Julien83910/Flipper/Rapport séance/Rapport séance 7.pdf

Séance du 16/02

Aujourd’hui je me suis occupé des bumpers qui fonctionnent comme des interrupteurs, donc la bille qui fait contacte entre le haut du bumper grâce à un fil de cuivre et le sol grâce à une plaque de cuivre aussi (malheureusement j’ai d’abord essayé avec une plaque en aluminium, le bumper fonctionnait mais on ne pouvait pas soudé dessus). Résultat le bumper fonctionnais, j’ai dû quand même redimensionner un peu mes pièces, il me reste plus qu’à les brancher correctement sur le plateau de jeu.

J’ai aussi construit la rampe de lancement, fais les trous dans la planche pour les bumpers.

Pour finir j’ai commencé à brancher les 2 gâchettes pour propulser la bille avec les boutons et les solénoïdes mais je n’ai pas eu le temps de finir le branchement.
