Julien83910/Flipper/Rapport séance/Rapport séance du 06.pdf

Rapport séance du 09/02

Aujourd’hui, j'ai collé toutes mes pièces sur le plateau de jeu, il est donc au complet. De plus, j’ai redimensionné les supports pour poser les capteurs et les moteurs solénoïdes, puis je les ai fait imprimer.

J’ai aussi essayé de faire fonctionner le moteur avec la gâchette à travers le plateau de jeu avec le mécanisme qui les relie, et ceci est un succès, les gâchettes sont ainsi fonctionnelles.

J’ai aussi soudé les fils sur les moteurs solénoïdes pour pouvoir les brancher.
