Julien83910/Flipper/Rapport séance/Rapport séance 05.pdf

Rapport séance 02/02/2023

Lors de cette séance, j'ai remplacé tous les capteurs électromagnétiques par des capteurs de lumières, car à travers le plexiglas, la lumière se détecte mieux. En effet, à travers les trous sur la planche, j'ai collé des disques de plexiglas que j’ai dessiné et découpé au préalable. Les capteurs ont été branchés, testés et approuvés.

De plus j’ai dessiné les cales qui vont servir à caler les capteurs et les moteurs solénoïde derrières la planche.

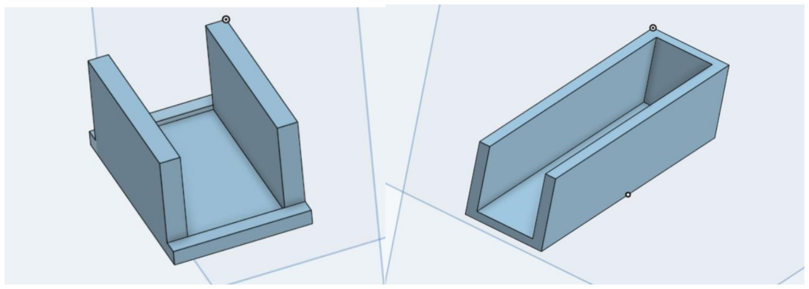
[picture p8: figure]
