Julien83910/Flipper/diapo projet.pdf

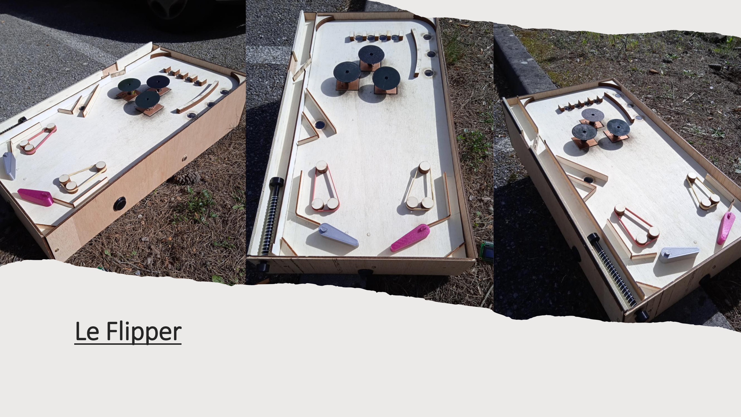
[picture p9: page 1]

FamilyID=Office_ArchiveTorn

Le Flipper

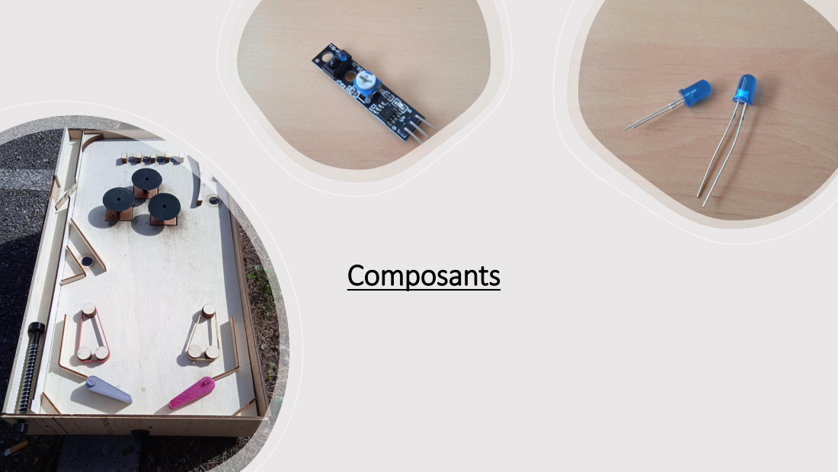
[picture p10: page 2]
Composants

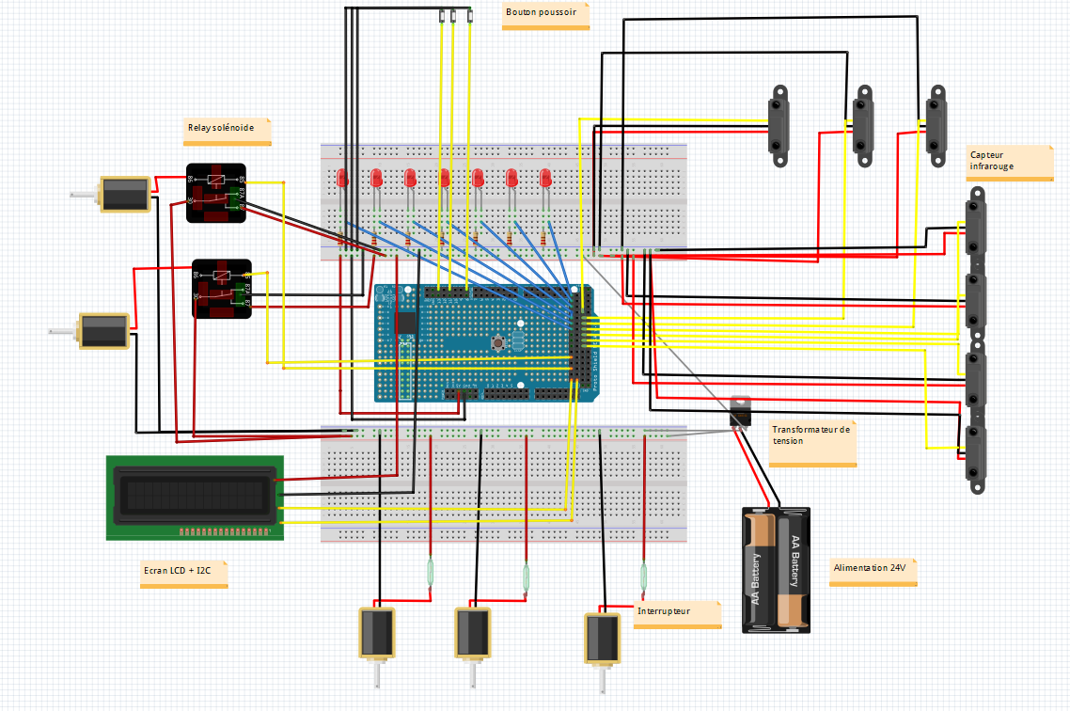
[picture p11: figure]

Schéma du
câblage

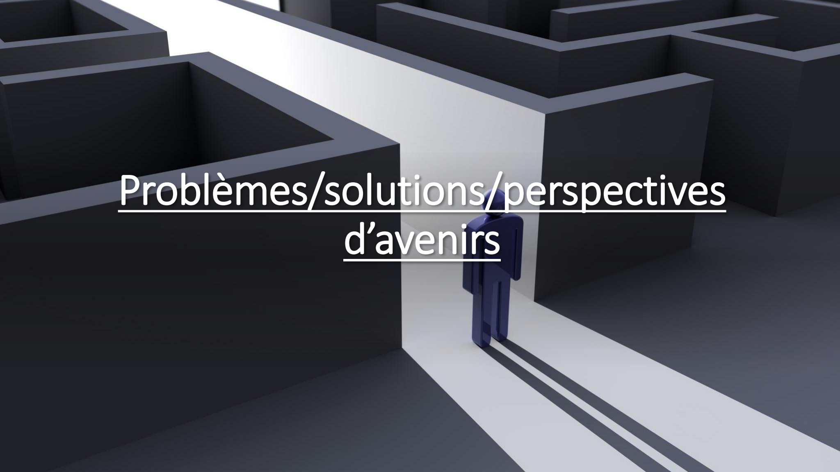
[picture p12: page 4]

Problèmes/solutions/perspectives d’avenirs

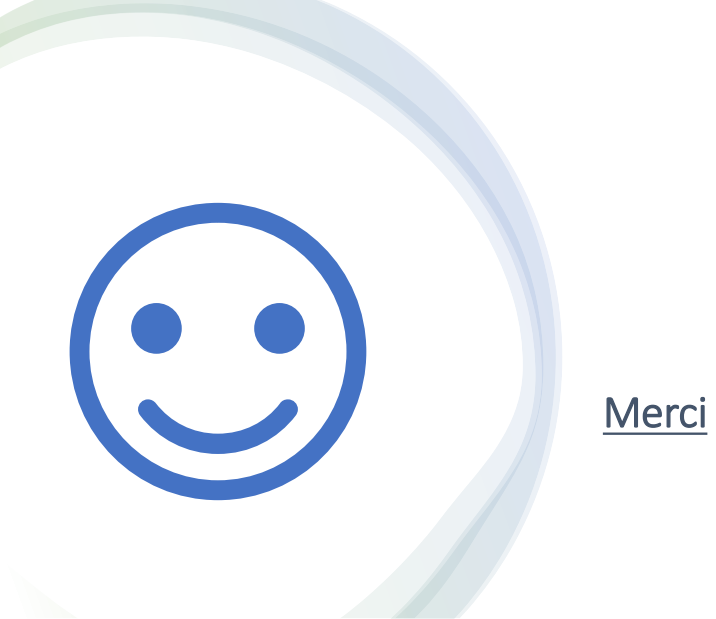
[picture p13: page 5]
Merci
