Julien83910/Flipper/Code/code_moteur_NEMA17/moteur_solénoide.ino

const int moteurGauche = 13;
const int moteurDroite = 12;


  

void setup() {
 pinMode(moteurGauche, OUTPUT);
 pinMode(moteurDroite, OUTPUT);
} 

void loop() {
  digitalWrite(moteurGauche, HIGH); 
  delay(1000); 
  digitalWrite(moteurGauche, LOW); 
  delay(1000);
} 
  
