Julien83910/Flipper/(commit log)

2022-12-12 1er cahier des charges
2022-12-12 Cahier des charges + Planning
